ghostintranslation/motherboard12/alt-not-tested/Motherboard12B-schematics-alt1.png

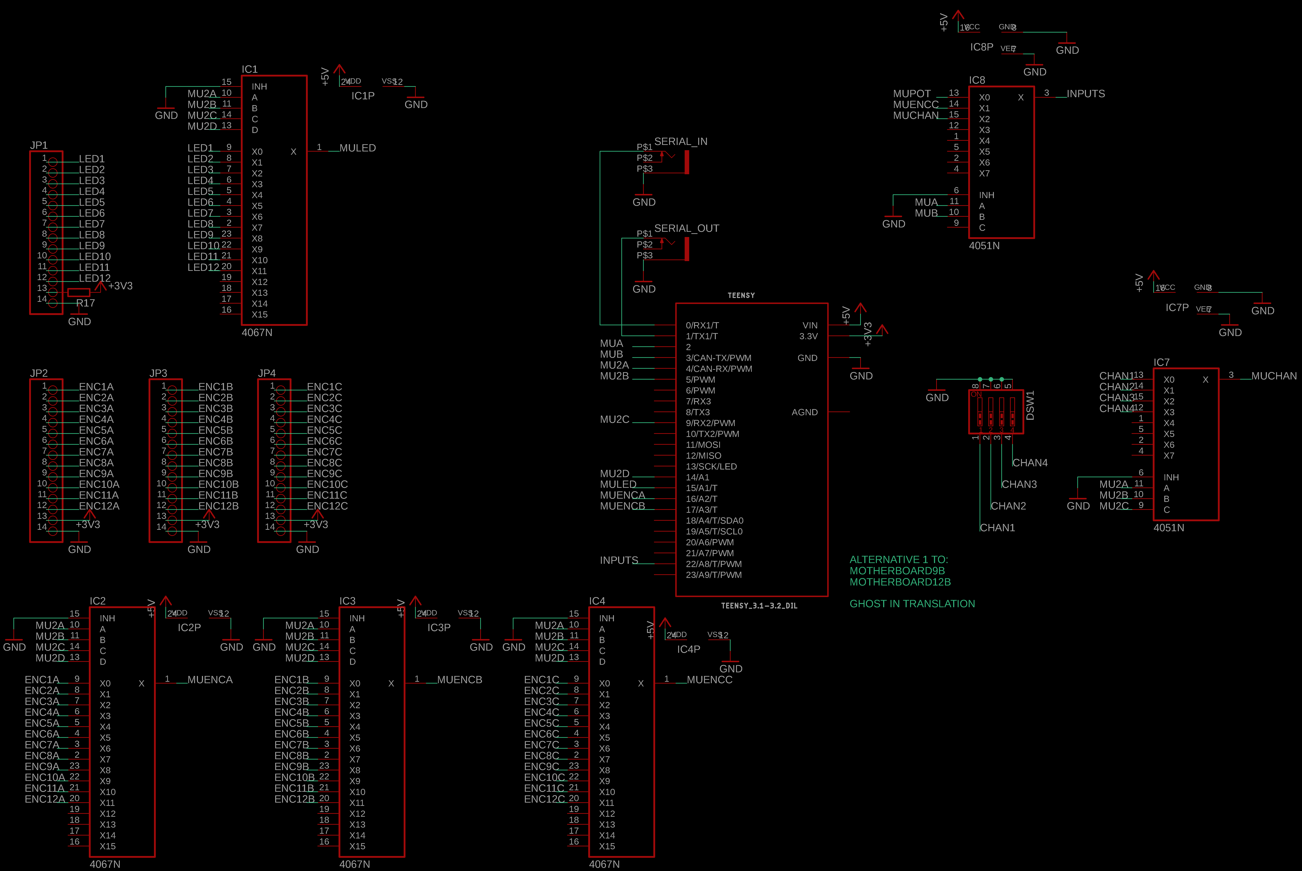
alt-not-tested/Motherboard12B-schematics-alt1.png
