ghostintranslation/motherboard12/alt-not-tested/Motherboard12B-schematics-alt2.png

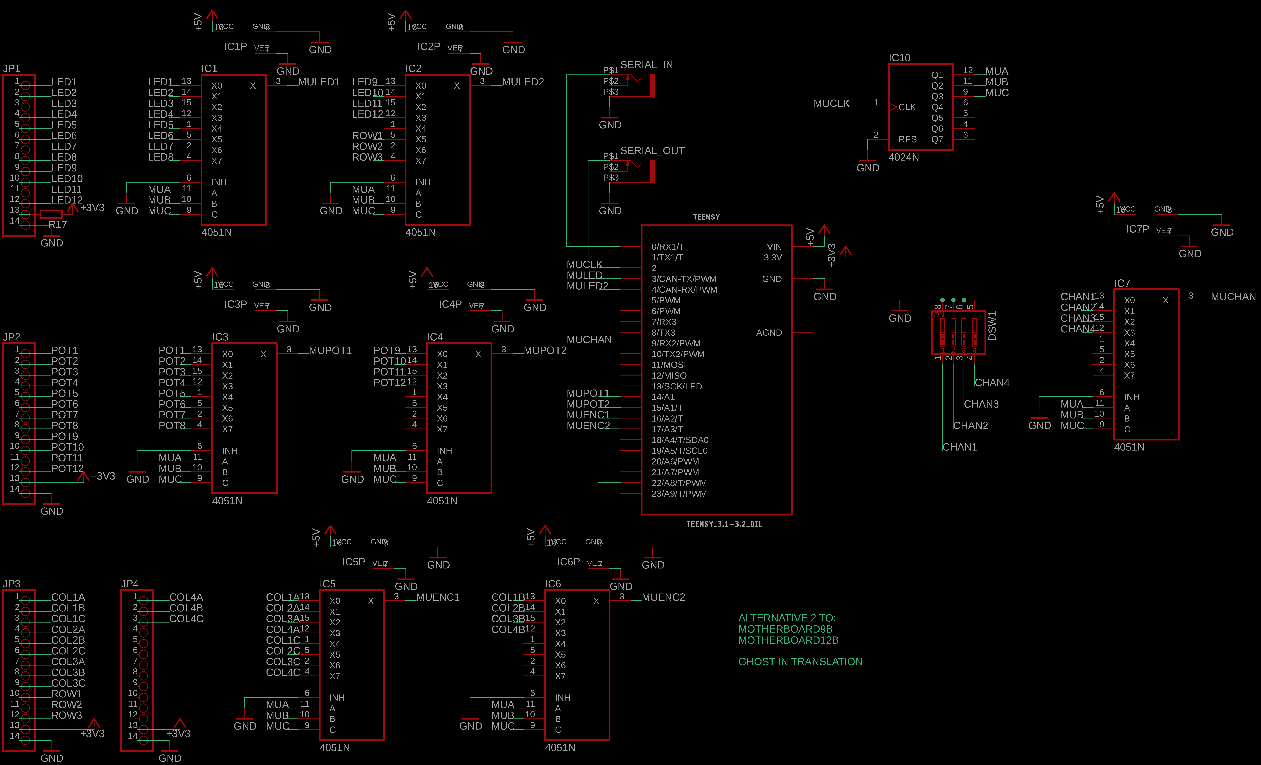
alt-not-tested/Motherboard12B-schematics-alt2.png
