ghostintranslation/motherboard12/(commit log)

2020-05-22 Alternative schematics in case it doesnt work
2020-06-27 Updated schematics
2020-07-03 - Used bool for buttons and switches - Improved potentiometers reading
2020-07-06 Improving encoders
    Improved encoders readings thanks to @buxtronix states table
2020-07-06 Encoder switch issue
    Fixed issue with encoders switch readings due to timing being too short
    [Motherboard12.h]
2020-07-17 Singleton and Improved encoders
    - Made Motherboard12 a singleton
    - Fixed wrong type of encoders variable
    - Fixed issue with LED interfering encoders readings
    [Motherboard12.h, Motherboard12.ino]
2020-07-19 Fixed MIDI channel
    Fixed Motherboard12 MIDI channel reading
    [Motherboard12.h, Motherboard12.ino]
2020-07-20 Fixed critical error
    - Fixed missing variable initisalization causing Teensy to crash and code not uploading on latest Teensyduino
    - Fixed linting
    [Motherboard12.h]
2020-07-23 Introducing callbacks
    Added click callbacks for buttons and rotary stwiches
2020-07-24 Improved callbacks
    - Renamed Click to Press
    - Added long press callback
    - Added rotary change callback
    - Renamed Display to LED
    - Added method to set all leds by a binary representation of a number
    - Added method to toggle one led
2021-03-10 Updated with changes from Motherboard6 to add led brightness control
2021-03-10 Fixed issue between analogWrite and digitalWriteFast leading to LED not at the right level after reaching full and going lower brightness
    [Motherboard12.h]
